piruetasxyz/plexo/plexo-v-0-rev-a/plexo-v-0-rev-a.kicad_pcb

## KiCad design plexo-v-0-rev-a/plexo-v-0-rev-a.kicad_pcb (2026-10-13)

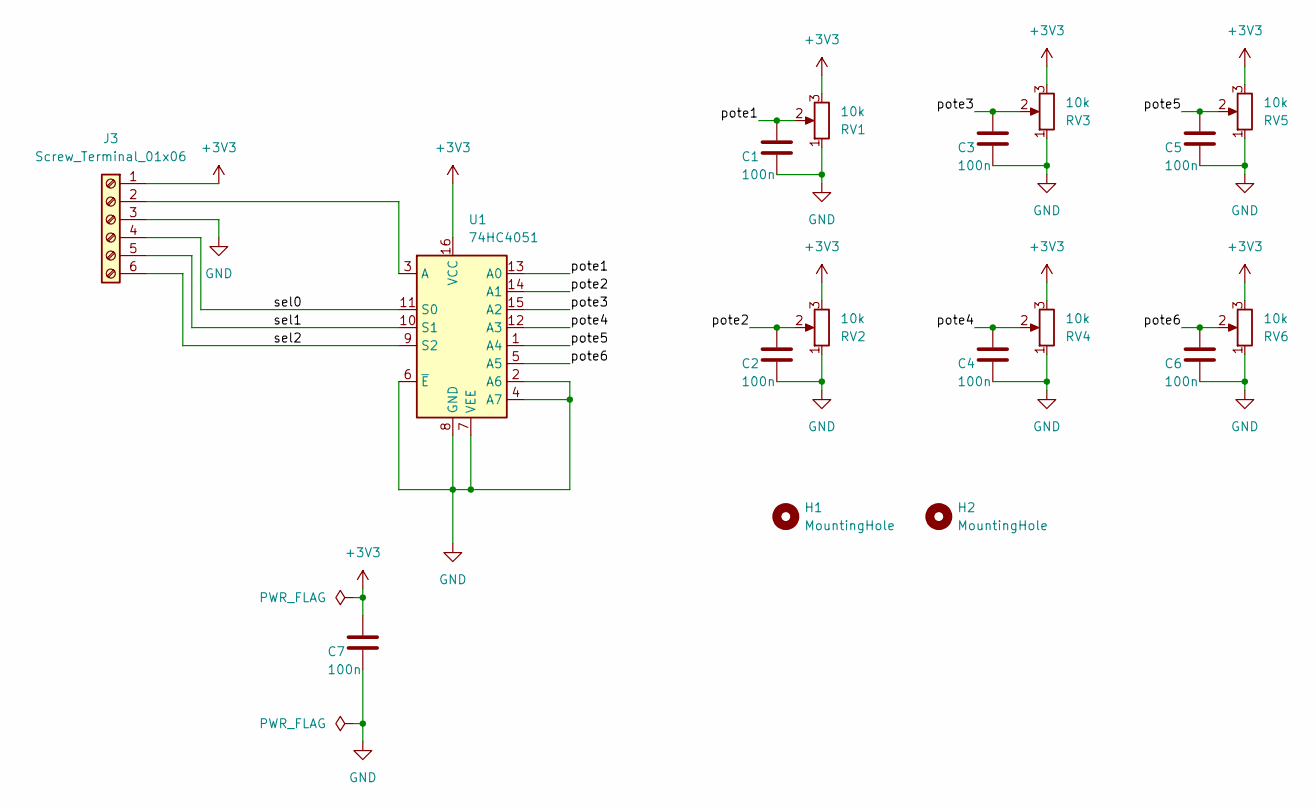
[picture p1: schematic plexo-v-0-rev-a.kicad_sch, plexo-v-0]

Parts:
C1, C2, C3, C4, C5, C6, C7: 100n; C_0805_2012Metric; LCSC C49678
H1, H2: MountingHole; MountingHole_3.2mm_M3
J3: Screw_Terminal_01x06; PinSocket_1x06_P2.54mm_Vertical
RV1, RV2, RV3, RV4, RV5, RV6: 10k; Potentiometer_Alpha_RD901F-40-00D_Single_Vertical
U1: 74HC4051; SOIC-16_3.9x9.9mm_P1.27mm; LCSC C9386

Connections:
+3V3: C7.1, J3.1, RV1.3, RV2.3, RV3.3, RV4.3, RV5.3, RV6.3, U1.16 (VCC)
/pote1: C1.1, RV1.2, U1.13 (A0)
/pote2: C2.1, RV2.2, U1.14 (A1)
/pote3: C3.1, RV3.2, U1.15 (A2)
/pote4: C4.1, RV4.2, U1.12 (A3)
/pote5: C5.1, RV5.2, U1.1 (A4)
/pote6: C6.1, RV6.2, U1.5 (A5)
/sel0: J3.4, U1.11 (S0)
/sel1: J3.5, U1.10 (S1)
/sel2: J3.6, U1.9 (S2)
GND: C1.2, C2.2, C3.2, C4.2, C5.2, C6.2, C7.2, J3.3, RV1.1, RV2.1, RV3.1, RV4.1, RV5.1, RV6.1, U1.2 (A6), U1.4 (A7), U1.6 (~E), U1.7 (VEE), U1.8 (GND)
unnamed: J3.2, U1.3 (A)

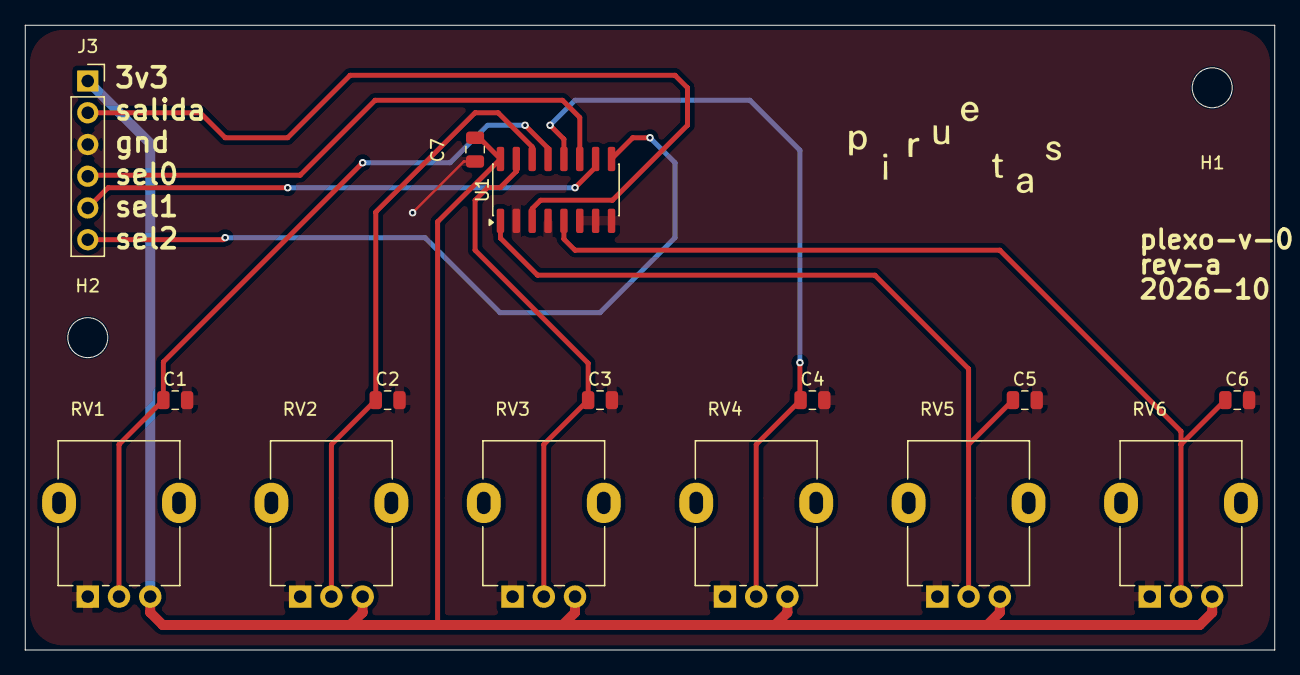
[picture p2: board plexo-v-0-rev-a.kicad_pcb from above]

Board: 2 copper layers, 100.0 x 50.0 mm, 17 parts (0 on the bottom side), 12 nets.
